alonsete99/Intercomunicador-para-bebes/Placa de interfaz/Esquemáticos/Esquemáticos placa de interfaz.docx

L

A

GND e J_

+5V - - - onn x 2_Fe ,le

U1 u

### + .3V P32-D[VK T -32D

+3.3 INMP 141

3 3 GND GN t G D

ND

2 ve

[N 1 23 - - 3- SD

SE SOP_VP I022 _!j

- - - sw

L/P

S- NSOR_VN T/DO

IQ3L ,XDO

7

]

ser

LED3 1035 ID 1

1032 GND GND B

1033 IQ_9

1 25 I018

D26 105

°' ..... Q_ ..... 1027 I017 U3

1

10_4 D1 LM3 6

t

1 12 104 GN T-

GND1 IDD 1 -

e, w e, ' D1 02 IN-

5D2 IQ_5 ce

1

-º•

º?

SD D1

MD DD

GND GND GND Ex-_sv Lr

o

C1

T+ - - 33 ,F Speare1

o

LS_

h e- :

## File : PI ca de i n -az sel

Title· Placa de interfaz

Size: A4 ele: 2022-01-11 Re : Alonso

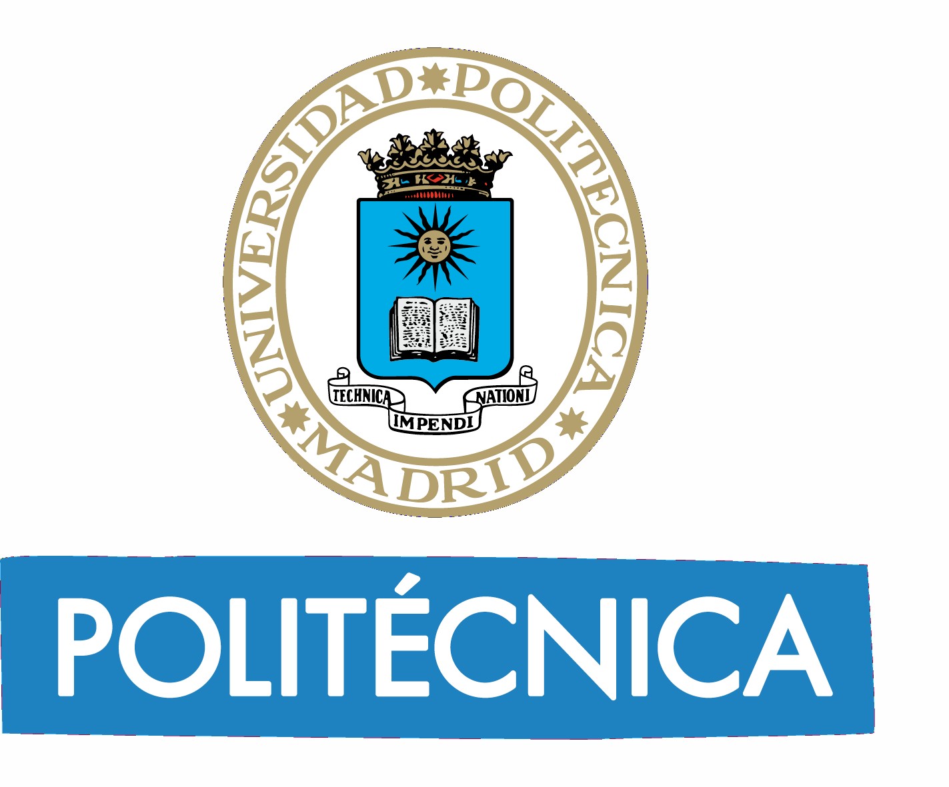
[picture p3: figure]
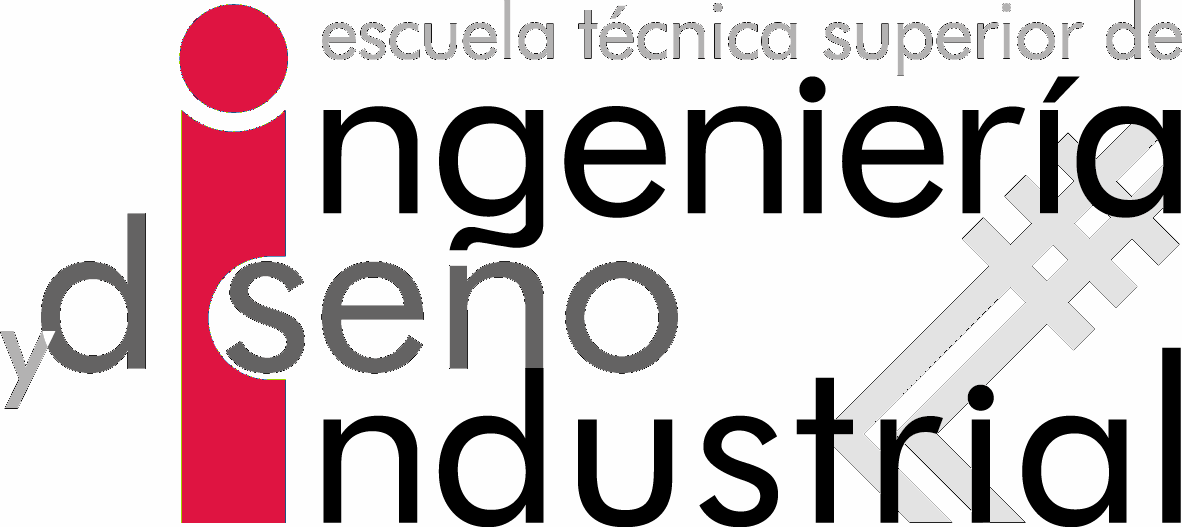
[picture p4: figure]

## KiCad E. O. A.

4

1 icad (5 .1. _0 )- 1

1

# I d : 1/1
