alonsete99/Intercomunicador-para-bebes/TFG_ALONSO_ALAMEDA_MORA.pdf

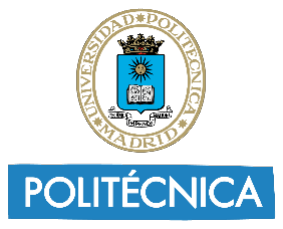
[picture p5: figure]

# UNIVERSIDAD POLITÉCNICA DE MADRID

### ESCUELA TÉCNICA SUPERIOR DE INGENIERÍA Y DISEÑO INDUSTRIAL

## Grado en Ingeniería Electrónica Industrial y Automática

# TRABAJO FIN DE GRADO

## Diseño y construcción de un intercomunicador para bebés

## Autor: Alonso Alameda Mora

Madrid, febrero, 2022

## Tutor: Raquel Cedazo León Departamento de ingeniería

eléctrica, electrónica,
automática y física aplicada.

ii

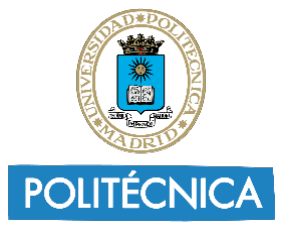
[picture p6: figure]

# UNIVERSIDAD POLITÉCNICA DE MADRID

### ESCUELA TÉCNICA SUPERIOR DE INGENIERÍA Y DISEÑO INDUSTRIAL

## Grado en Ingeniería Electrónica Industrial y Automática

# TRABAJO FIN DE GRADO

## Diseño y construcción de un intercomunicador para bebés

## Autor: Alonso Alameda Mora

Madrid, febrero, 2022

## Tutor: Raquel Cedazo León Departamento de ingeniería

eléctrica, electrónica,
automática y física aplicada.

Título del trabajo:

Autor:

Tutor:

Co-tutor:

### EL TRIBUNAL

### Presidente:

### Vocal:

### Secretario:

Realizado el acto de defensa y lectura del Trabajo Fin de Grado el día ..... de
| de | en | , en la Escuela Técnica Superior de Ingeniería y
Diseño Industrial de la Universidad Politécnica de Madrid, acuerda otorgarle la CALIFICACIÓN de:

VOCAL

SECRETARIO
PRESIDENTE

# AGRADECIMIENTOS

De bien nacido es ser agradecido

# ÍNDICE

AGRADECIMIENTOS | I
ÍNDICE | I
RESUMEN | III
ABSTRACT | IV
GLOSARIO | V
LISTA DE ABREVIATURAS | V
LISTA DE SÍMBOLOS | VI

ii

iii

# RESUMEN

iv

# ABSTRACT

Abstract

v

# GLOSARIO

## LISTA DE ABREVIATURAS

TFG | Trabajo Fin de Grado
ETSIDI | Escuela Técnica Superior de Ingeniería y Diseño Industrial
PCB | Printed Circuit Board (Placa de circuito impreso)
UDP | User Datagram Protocol
IDE | Entorno de Desarrollo Integrado

vi

## LISTA DE SÍMBOLOS

Ω | Ohmio
W | Watio
V | Voltios
Hz | Hercios
dB | Decibelios
mA | Miliamperios

## INDICE DE FIGURAS

FIGURA 6: GRÁFICA POTENCIA A LA SALIDA VS DISIPACIÓN DEL COMPONENTE .... 19

FIGURA 9: DIODO LED ROJO | ¡ (https://upm365-my.sharepoint.com/personal/alonso_alameda_mora_alumnos_upm_es/Documents/TFG_ALONSO_ALAMEDA_MORA.docx)ERROR! MARCADOR NO DEFINIDO. (https://upm365-my.sharepoint.com/personal/alonso_alameda_mora_alumnos_upm_es/Documents/TFG_ALONSO_ALAMEDA_MORA.docx)

# Capítulo 1.INTRODUCCIÓN

### 1.1. INTRODUCCIÓN AL TEMA DEL TFG

### 1.2. MOTIVACIONES

Introducción

### 1.3. OBJETIVOS

El objetivo de este trabajo es diseñar y construir un intercomunicador especializado para bebes. Como objetivos específicos tenemos:

- Diseño y construcción del hardware del intercomunicador.
- Desarrollo del software que controla todos los componentes del intercomunicador
- Desarrollo de una aplicación móvil que se comunique con el intercomunicador y envía sonido en ambos sentidos
- Realizar pruebas de funcionamiento del intercomunicador.

### 1.4. ESTRUCTURA DEL DOCUMENTO

# Capítulo 2.ESTADO DEL ARTE

## 2.1. ORIGEN

La tecnología de comunicación entre oficinas es anterior a los walkie-talkies por décadas. Después de que Kellogg patentara el primer sistema de intercomunicación telefónica en 1894, la capacidad de comunicarse con los empleados o transmitir informes oficiales a todo el edificio dio un gran paso adelante. Como sugiere el nombre, los primeros walkie-talkies dependían de la tecnología de telefonía, pero los fabricantes continuaron mejorando el sistema mediante la adopción de nuevas tecnologías.

Tubos de lengua

Las empresas del siglo XIX desarrollaron métodos de comunicación entre varias oficinas de patentes antes de Kellogg. A principios de la década de 1800, los ingenieros construyeron tuberías para transmitir sonido entre dos altavoces en el mismo edificio. Algunos sistemas funcionan a distancias de cientos de metros. La tubería se convirtió en una tecnología comercial común en la segunda mitad del siglo. En la década de 1880, el sistema era lo suficientemente sofisticado como para que los parlantes pudieran conectarse a cualquiera de las 25 oficinas diferentes. Algunos ejecutivos prefieren una alternativa, un sistema de timbre de habitación en habitación para llamar a sus empleados.

Intercomunicadores basados en teléfonos

Este tipo de intercomunicadores se desarrollaron en la década de 1890. Estos sistemas conectaban dos teléfonos de dos oficinas distintas, pero pronto se empezaron a desarrollar conexiones más complejas. Se diseño el primer sistema radial, el cual los usuarios tenían que llamar a una estación central donde se le redirigía a la oficina la cual se querían poner en contacto.

Intercomunicadores durante el siglo XX

Durante el año 1912, los usuarios ya tenían la opción de elegir entre un teléfono o un altavoz el cual les permitía trabajar con las manos desocupadas. En esta década la mayoría de los intercomunicadores todavía se parecía a lo que convencionalmente llamamos como teléfono. A partir de la década de 1950, los intercomunicadores empezaron a ser utilizados como porteros electrónicos para realizar la comunicación y apertura de los edificios. El gran cambio en los intercomunicadores llegó a raíz de la invención del transistor en el año 1951 por William Shockley[1].

A partir de la invención del transistor se inició la etapa de la digitalización. A partir del 1982, los fabricantes de intercomunicadores empezaron a vender dispositivo que además de audio incorporaban video.

Esta información se ha obtenido de la siguiente referencia [2]

# Capítulo 3.FUNDAMENTOS

# TEÓRICOS

### 3.1. ¿QUÉ ES UN INTERCOMUNICADOR?

Un intercomunicador es un dispositivo electrónico de comunicación bidireccional¹ que permite la comunicación entre dos interlocutores a través de una conexión establecida entre ambos.

1 Bidireccional: Comunicación que se realiza en dos sentidos, desde el emisor al receptor y viceversa.

### 3.2. EL SONIDO

## 3.3. WIFI

3.4. I2S

I2S o también conocido como Inter-IC Sound, es un estándar de bus serie que se utiliza para conectar diferentes dispositivos de audio de manera digital. Este estándar tiene la particularidad de poder habilitar el acceso directo a memoria o más comúnmente llamado DMA.

## 3.5. USER DATAGRAM PROTOCOL (UDP)

# Capítulo 4.DISEÑO HARDWARE

### 4.1. DESCRIPCIÓN DE LOS COMPONENTES UTILIZADOS

En este apartado se va a explicar con profundidad las diferentes alternativas que hay en el mercado para cada parte fundamental del proyecto. En primer lugar, para este proyecto se planteó la idea de diseñar dos dispositivos que se comunicaran entre ellos. Esta idea encarecía bastante el sistema y no habría ningún tipo de mejora con respecto a un intercomunicador para bebes convencional. Por tanto, se decidió diseñar solo un dispositivo que se comunicara con la aplicación móvil.

Las partes fundamentales del dispositivo son las siguientes:

- Microcontrolador
- Micrófono
- Altavoz
- Etapa preamplificadora de señal
- Diodos Led
- Fuente de alimentación

4.1.1. MICROCONTROLADOR

Como elección de microcontrolador se ha elegido el ESP-WROOM-32, se trata de un módulo que dispone de WIFI y Bluetooth, el cuál es ideal para el proyecto ya que toda la comunicación entre la aplicación móvil y el microcontrolador va a ser inalámbrica. Además, este módulo tiene un consumo energético cuando se encuentra en reposo muy bajo (5 μA aproximadamente). Este módulo está fabricado por la empresa Espressif, la cual tiene una amplia guía de programación, en la cual se detallan cómo programar integrar las diferentes funciones y librerías que tiene el módulo disponible.

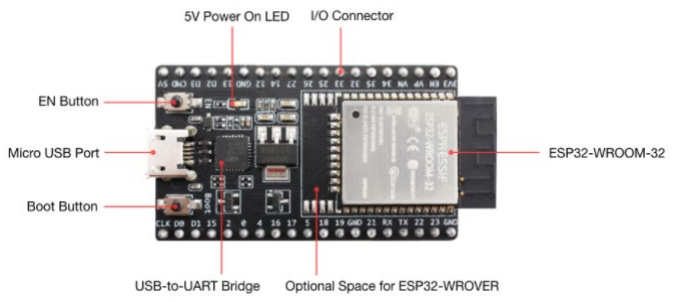
[picture p7: figure]

Figura 1: ESP32-DevKitC V4.

Otro valor diferencial en cuanto a otras placas del mercado es su tamaño reducido ya que mide 56x28mm. Esto hace que uno de los requisitos de este proyecto se pueda cumplir ya que es primordial que el intercomunicador tenga un tamaño reducido para que sea lo más portable posible.

Por último, esta placa dispone del estándar I2S, como se explica con más detalle en el apartado 3.4, se va a utilizar para digitalizar la señal de audio recibida del micrófono. Una vez que la señal analógica se encuentre digitalizada se realizará un paquete de formato UDP y se enviará a la aplicación móvil.

EXTENDERSE UN POCO MÁS EN LAS CARACTERISTICAS DE LA PLACA FLASH RAM,ETC

4.1.2. MICRÓFONO

Como micrófono se ha elegido el INMP441. Se trata de un micrófono omnidireccional² basado en el protocolo I2S, con una precisión de muestras de hasta 24 bits. Tiene una respuesta en frecuencia desde 60Hz hasta 15kHz, lo que hace que se más que suficiente para integrarlo en el intercomunicador. Además, este micrófono se alimenta a una tensión de 3.3V, que se pueden obtener del regulador DC/DC de 5V a 3.3V que tiene integrado el módulo de ESP32.

Este micrófono viene integrado sobre una placa de interfaz la cual es fácil de poder soldarse posteriormente sobre una PCB.

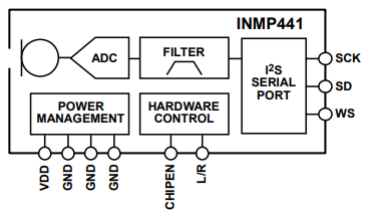
[picture p8: figure]
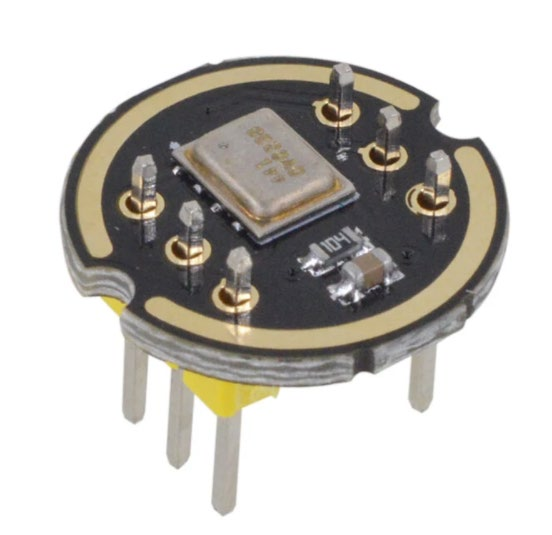
[picture p9: figure]

2 Micrófonos omnidireccionales: son aquellos los cuales tienen una sensibilidad constante, esto significa que capta los sonidos en todas las direcciones. Fuente: Wikipedia.org

Figura 2: Diagrama de bloques INMP441 Figura 3: Placa de interfaz INMP441

### 4.1.3. ALTAVOZ

El altavoz es el encargado de transformar la señal eléctrica que transmite la placa ESP32 en sonido. Para ello se ha elegido un altavoz de 8 Ω, el cual tiene unas dimensiones de 28 mm de diámetro y tiene una potencia nominal de 0.25W. Además, como se puede observar en la Figura 5, la respuesta del altavoz se va a encontrar entre 80-90dB ya que la canción que se va a reproducir no tiene un espectro con altas frecuencias, lo que hace que el altavoz no llegue a saturarse y por tanto reproduzca un sonido con mala calidad.

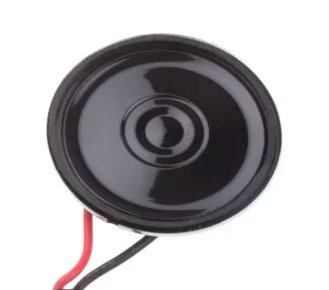
[picture p10: figure]
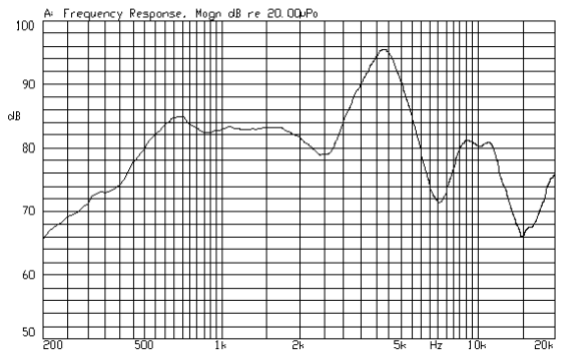
[picture p11: figure]

4.1.4.ETAPA AMPLIFICADORA DE SEÑAL

Esta etapa es necesaria de añadir entre el altavoz y el módulo ESP32 ya que este módulo es capaz de suministrar una señal de salida de 15 mA, lo cual es insuficiente para que en el altavoz se escuche el sonido con claridad. Si se conecta directamente el altavoz al módulo consumiría una potencia máxima que se muestra en la siguiente ecuación:

# PPmmmmmm = VV ∗ IImmmmmm = 3.3VV ∗ 15mmmm = 49.5mmmm

Esto hace que la potencia máxima consumida sea del 19.8% del valor total del altavoz. Por tanto, hay que añadirle la etapa amplificadora de señal para que ese porcentaje se aproxime al 100% del valor de potencia.

Figura 4: Altavoz 8 Ω | Figura 5: Respuesta en frecuencia del Altavoz

Como amplificador se ha elegido el LM386, el cual es un amplificador operacional diseñado explícitamente para trabajar en labores de sonido. Este amplificador tiene las siguientes características:

Tabla 1: Características

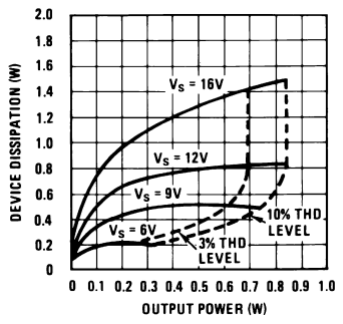
[picture p12: figure]
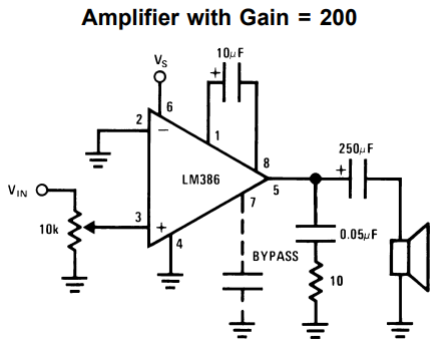
[picture p13: figure]

Como se muestra en la Figura 6, la curva inferior va a ser la que represente la potencia en la salida del amplificador, ya que el sistema se va a encontrar alimentado por 6V. Con esto se observa que la potencia máxima a la salida va a ser de 0.3W lo cual es aproximadamente la misma potencia que soporta el altavoz. Además, si no se superan los 0.3W el THD es del 0.2%, lo cual hace que la señal no se distorsione al aumentar la tensión a la salida del módulo.

Parámetro | Valor
Tensión de alimentación | 4-12V
Ganancia en la tensión de salida | 26-46dB
Ancho de banda | 300kHz
Distorsión armónica total | 0.2%

Figura 6: Gráfica potencia a la salida vs disipación del componente

Figura 7: Circuito amplificador con ganancia 200

Para hacer el diseño lo más simplificado posible, se ha decidido comprar este amplificador operacional pero ya montado y soldado sobre un módulo. Además, ya vienen incluido todos los componentes que aparecen en la Figura 7. Este diseño dispone de un amplificador LM386 con una etapa de filtrado a la salida compuesta por un condensador y una resistencia. También dispone de un potenciómetro a la entrada del amplificador para regular la ganancia total del circuito y diferentes conectores para poder incluirlo dentro del prototipo.

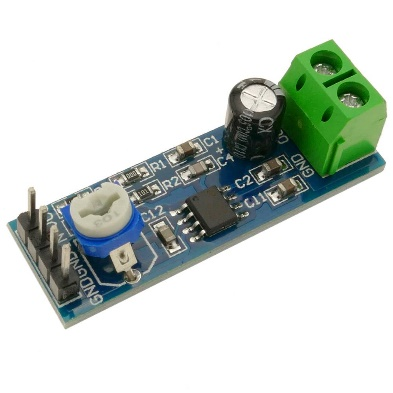
[picture p14: figure]

4.1.5.FUENTE DE ALIMENTACIÓN

Para alimentar todo el prototipo se ha decidido utilizar un conjunto de pilas de 1.5V. Este conjunto está formado por 4 pilas de tipo AAA, las cuales en su conjunto son capaces de suministrar al dispositivo 6V ya que todas se encuentran conectadas en serie entre sí. Se ha decidió elegir el conjunto de pilas ya que la mayoría de las baterías del mercado de dimensiones pequeñas suministraban a la salida una tensión de 3.3V, la cual no era suficiente ya que el módulo amplificador trabaja a una tensión mínima de 6V. Teniendo en cuenta que el conjunto de 4 pilas tiene una capacidad total de 1200 mAh. Se realiza un cálculo para conocer cada cuanto tiempo será necesario cambiar las pilas.

# TTTTTT TTTT = EEEE EEEEíaa ssss ssss ss

# PP PP (MMó dd EEEE 32 + MM ) = 6VV ∗ 1200mmmmℎ 80mmmm ∗ 3.3VV + 1.4mmmm ∗ 3.3VV = 26.86 ℎ

Por tanto, se concluye que la duración media del conjunto de pilas va a ser de 27 horas aproximadamente. Este cálculo se ha realizado teniendo como consumo principal el del

Figura 8: Módulo amplificador de potencia módulo ESP32 y el micrófono ya que van a ser los dispositivos que se van a encontrar la mayoría del tiempo funcionando cuando el dispositivo se encuentre encendido.

4.1.6. DIODOS LEDS

Los diodos leds son los encargados de notificar al usuario ante diferentes funciones que está desempeñando la placa. Para ello, se ha decidido utilizar diodos de color rojo, los cuales tienen una buena intensidad lumínica y buena durabilidad. Para el diseño inicial se han incluido 3 Leds los cuales tienen las siguientes funcionalidades:

- LED 1: Este led es el encargado de notificar al usuario de que se ha conectado correctamente a la red Wifi creada por el intercomunicador. Además, si por cualquier motivo el cliente se desconecta de la red se apaga para que el usuario no tenga dudas si la conexión es correcta.
- LED 2: Este es el diodo que se encuentra en la parte central de la hilera de leds. En este caso, notifica al usuario de que se ha iniciado el modo de escucha y por tanto todo lo que escuche el micrófono se va a enviar a la aplicación móvil, donde se reproducirá el sonido ininterrumpidamente.
- LED 3: En este caso, notifica al usuario que se ha iniciado el modo de reproducción de sonido por el altavoz. Una vez que se inicialice este modo aparecerá por el micrófono una canción que recibe el módulo ESP32 de la aplicación móvil.

Por último, todos los leds tienen conectados en serie una resistencia fija de valor 1kΩ, la cuales son las encargadas de limitar la corriente que circula a través de los diodos. El conjunto de diodo y resistencia se encuentran conectados a la placa como se muestra en la Figura 10, la cual es capaz de suministrar una tensión de 3.3V. Estos diodos tienen una caída de tensión entre sus bornas de 1.9V y una tensión máxima de operación definida por el fabricante de 30 mA. Como se muestra en la siguiente ecuación, la resistencia en serie del diodo debe tener un valor superior al obtenido ya que con ello se obtendrá una corriente menor a la máxima dada por el fabricante y no habrá riesgo de que se fundan.

RR ≥

# TTTT TTó aa aa ó − CC ó

# CC aa aa = 3.3VV − 1.9VV

30 ∗ 10−3 = 46.6 Ω

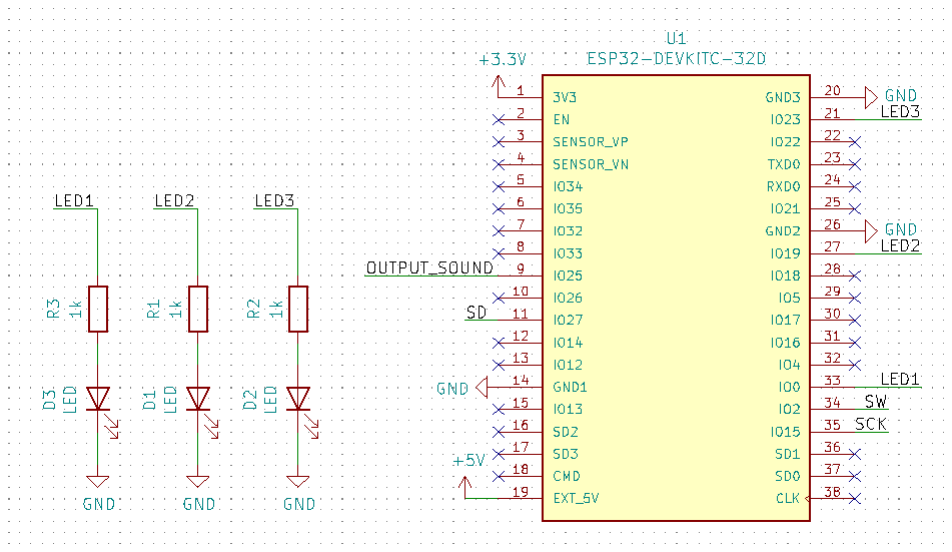
[picture p15: figure]
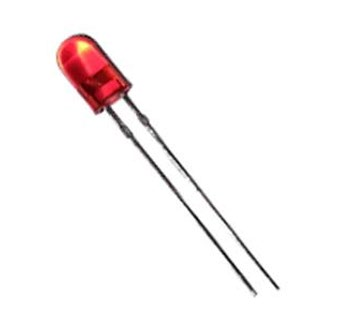
[picture p16: figure]

Figura 9: Diodo LED rojo | Figura 10: Conexión LEDs con ESP32

# Capítulo 5.DISEÑO SOFTWARE

5.1.1.INTRODUCCIÓN

En el siguiente capitulo se va a explicar con detalle todo el proceso que se ha seguido hasta conseguir que el dispositivo funcione correctamente. En primer lugar, se expone el programa realizado para el módulo ESP32. Este software está basado en el lenguaje de programación C++, el cual se ha estudiado con bastante detalle a lo largo de los estudios de grado.

En segundo lugar, se explicará el funcionamiento y programación de la aplicación móvil diseñada expresamente para este desempeño. Este programa a diferencia del anterior se encuentra desarrollado en Java, el cual me ha costado más ya que no lo había estudiado con anterioridad.

Por último, se va a exponer un programa que se ha realizado para ir comprobando que el sonido se estaba transmitiendo correctamente en ambos sentidos. Este programa se encuentra desarrollado en Python ya que este lenguaje de programación dispone de una librería la cual hacía muy sencillo poder reproducir sonido a través de un socket UDP.

5.1.2. CONEXIÓN INALÁMBRICA

Como se ha explicado con anterioridad, se va a realizar una conexión inalámbrica entre el módulo ESP32 y el dispositivo móvil. Para ello, el ESP32 se va a programar de manera que se comporte como Punto de acceso Wifi. Una vez que la red local se haya creado correctamente, el dispositivo móvil se deberá conectar a ella y entra a la aplicación móvil.

Desde la aplicación móvil se podrá elegir entre los dos modos de comunicación implementados. En el primer modo, el dispositivo móvil abrirá el archivo de la canción que se desea enviar para relajar al bebe, guardado dentro de la aplicación. Estos datos posteriormente se irán enviando por orden para que una vez que el ESP32 reciba dicha información la reproduzca por el altavoz del intercomunicador.

El segundo modo, el ESP32 obtendrá el sonido ambiente desde el micrófono que se encuentra integrado en el intercomunicador, realizará una amplificación de señal digitalmente para que se escuche con un volumen más alto y nítido y se enviará al dispositivo móvil donde se reproducirá por el altavoz del dispositivo. El objetivo es que esta comunicación se realice con el menor retardo posible y con la mejor calidad de sonido.

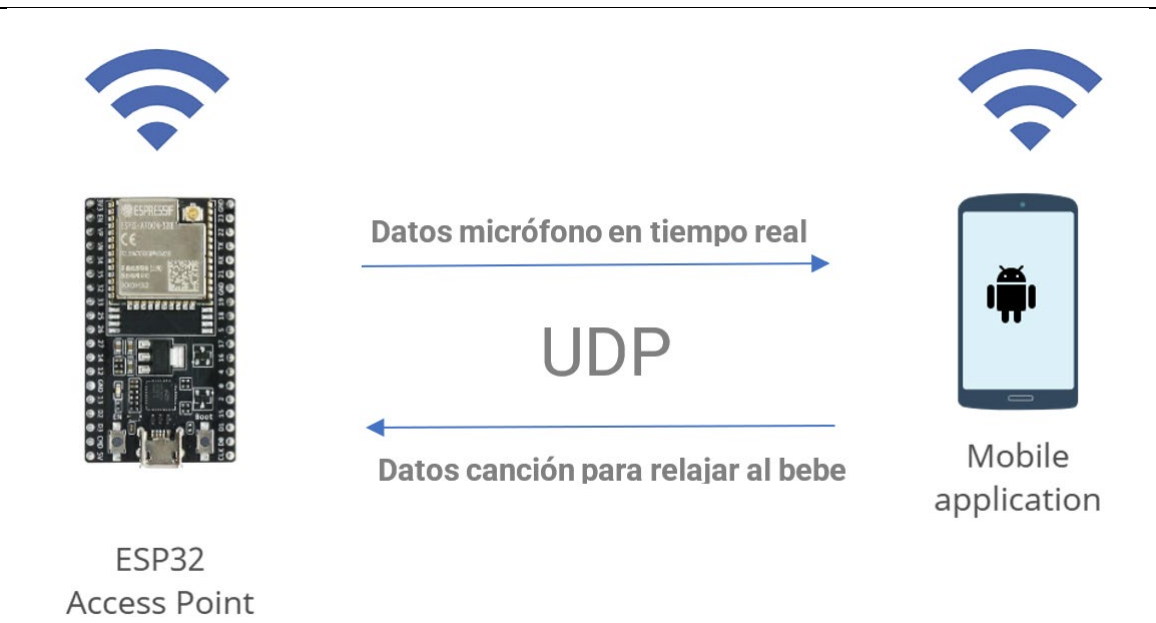
[picture p17: figure]

Figura 11: Diagrama de conexión inalámbrica

### 5.1.3. SOFTWARE PLACA ESP32

Este módulo se ha decidido programarse con el IDE de Arduino ya que tiene ya integradas muchas librerías especializadas para poder desempeñar las tareas que deseo. Además, Arduino tiene una comunidad muy activa en sus foros y si se tiene algún problema con alguna parte del código suele haber alguna solución ya planteada para dicho programa. Otra alternativa para programar el módulo era utilizar Visual Studio Code con la extensión de PlataformIO instalada. El problema con esta extensión era que en muchas ocasiones me aparecían fallos al programar código que hacía que el módulo estuviera constantemente reiniciándose. Este fallo creo que era porque al añadir varias clases al proyecto global hacía que superara la memoria Flash del módulo, haciendo que me imprimiera un fallo del Kernel de la placa y reiniciara constantemente el módulo.

Para realizar el programa completo del módulo se ha utilizado la guía de programación que tiene la empresa Espressif. Se trata de una guía muy completa donde se explican todos los parámetros primordiales para poder programar su módulo. Entre ellos he utilizado con mayor frecuencia el de Bluetooth, Wifi o I2S.

A continuación, se va a explicar con detalle todas las funciones implementadas en el código:

- ReceivingTask(): Esta tarea se encarga en recibir continuamente datos desde la aplicación móvil y reproducirlos por el altavoz del dispositivo. Para ello se crea un buffer de 1024 bytes, el cual va a ser el encargado en almacenar la información. Se utiliza el comando “read” de la librería UDP.h. Este comando espera hasta que llegue un dato de 1024 bytes y lo almacena en el buffer llamado “buff_reciv”. Una vez que se ha detectado que ha llegado un dato, se realiza un bucle en el cual se escribe en el conversor digital analógico que tiene dicha placa. Para ello, se utiliza el comando “dacWrite”, el cual hay que especificarle el pin de la placa por donde quieres que salga la información (Pin 25) y la muestra que quieres hacer la conversión (“buff_reciv[i]”). Por último, se realiza una espera por cada muestra de 56 µs. Este valor se obtiene porque la canción enviada tiene una frecuencia de muestras de 16kHz. Por tanto, aplicando la siguiente formula se obtiene el valor de retardo:

TT = 1

ff = 1

# 16000 = 62.5µss

A este retardo obtenido hay que restarle 7µs aproximadamente que es lo que tarda la placa en realizar la conversión del dato digital en analógico, con lo que finalmente se obtiene el valor de 56 µs de retardo entre cada muestra.

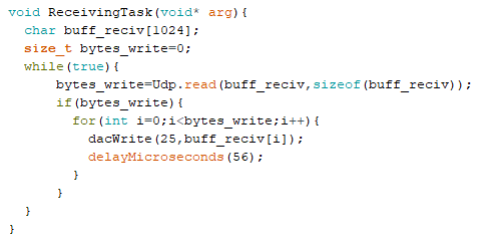
[picture p18: figure]

- SendingTask(): Esta tarea es la encargada de enviar los datos obtenidos del micrófono a la aplicación móvil a través de un socket UDP.

Figura 12: Función ReceivingTask()

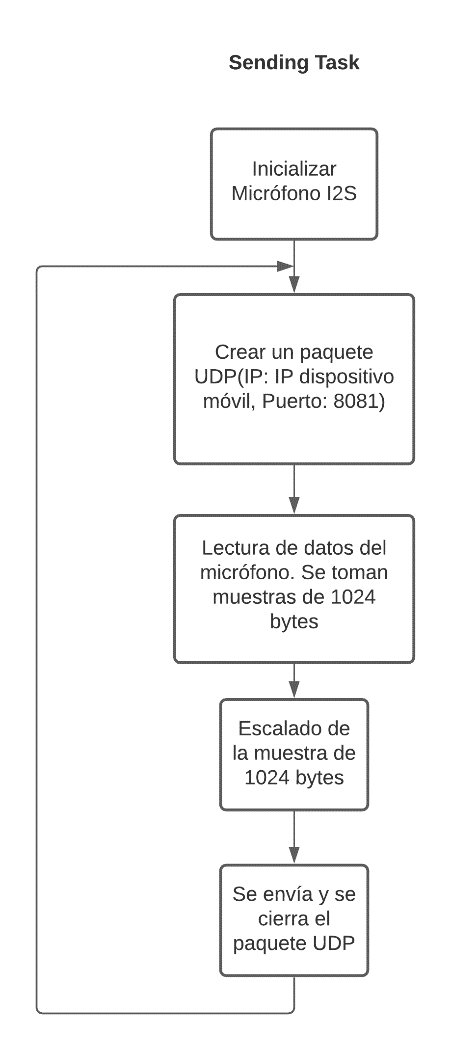
[picture p19: figure]

Figura 13: Diagrama de flujo función SendingTask()

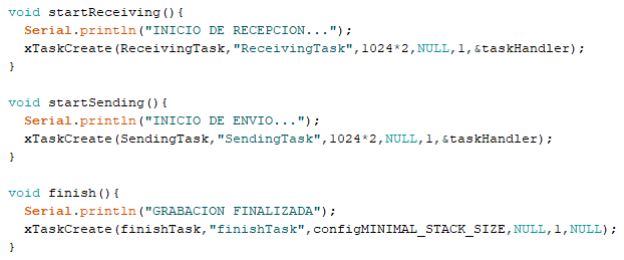
[picture p20: figure]

Figura 14: Funciones que crean las tareas

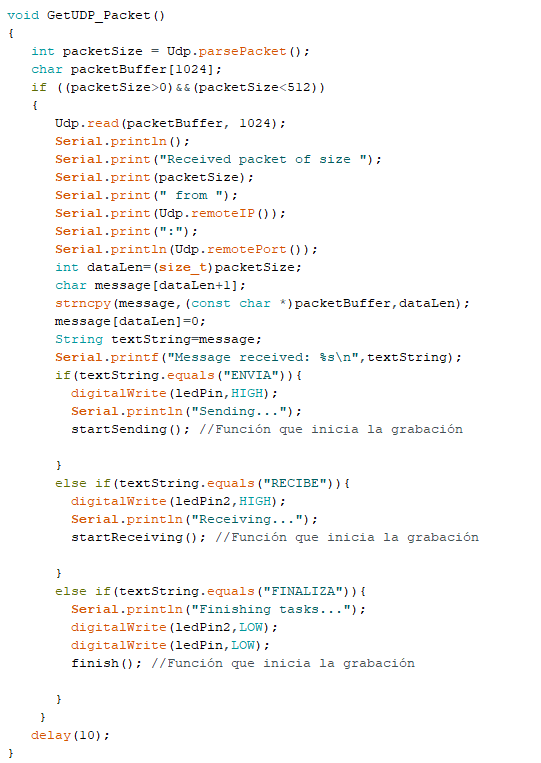
[picture p21: figure]

Figura 15: Función GetUDP_Packet()

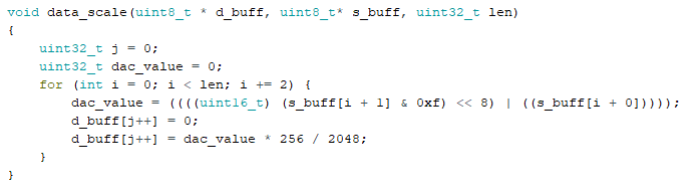
[picture p22: figure]
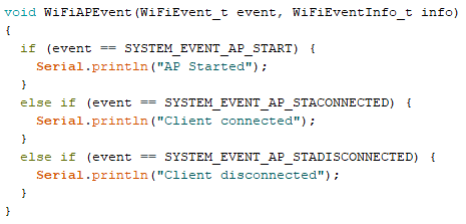
[picture p23: figure]

Figura 17:Función WiFiAPEvent()

Figura 16: Función data_scale()

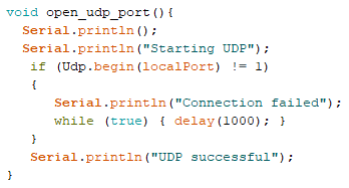
[picture p24: figure]

Figura 18: Función open_udp_port()

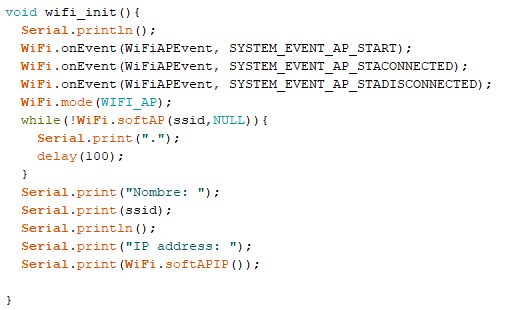
[picture p25: figure]

Figura 19: Función wifi_init()

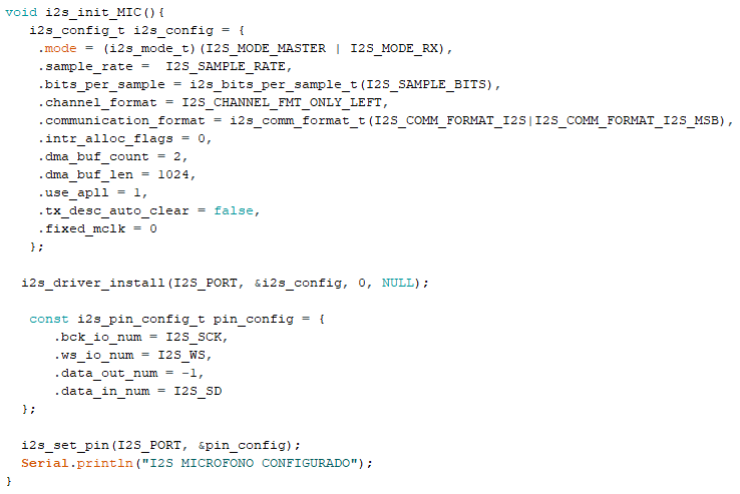
[picture p26: figure]

Figura 20: i2s_init_MIC()

5.1.4. SOFTWARE APLICACIÓN MÓVIL

En este caso se ha utilizado Android Studio para implementar la aplicación desde cero. Se trata de un entorno de programación muy cómodo ya que tienen implementadas muchas librerías de java las cuales son fáciles de importar e implementar en el código.

# Capítulo 6.RESULTADOS

### 6.1. RESULTADOS

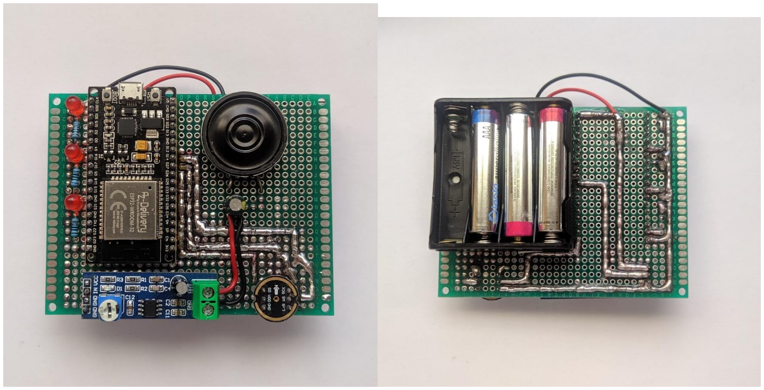
[picture p27: figure]

### 6.2. DISCUSIÓN

# Capítulo 7.CONCLUSIONES Y FUTUROS TRABAJOS

### 7.1. CONCLUSIONES

## 7.2. FUTUROS TRABAJOS

# BIBLIOGRAFÍA

[1] | “Historia | del | transistor | - | Wikipedia, | la | enciclopedia | libre.”
https://es.wikipedia.org/wiki/Historia_del_transistor (accessed Jan. 19, 2022).
[2] | “Historia | de | los | sistemas | de | intercomunicación | / | Pretexsa.com.”
http://www.pretexsa.com/eM9A20DM.html (accessed Jan. 19, 2022).

# ANEXO A. ANEXO DE EJEMPLO

### A.1. SECCIÓN 1 DEL ANEXO
