alonsete99/Intercomunicador-para-bebes/Placa de interfaz/Imagenes modelo 3D/Vista inferior.png

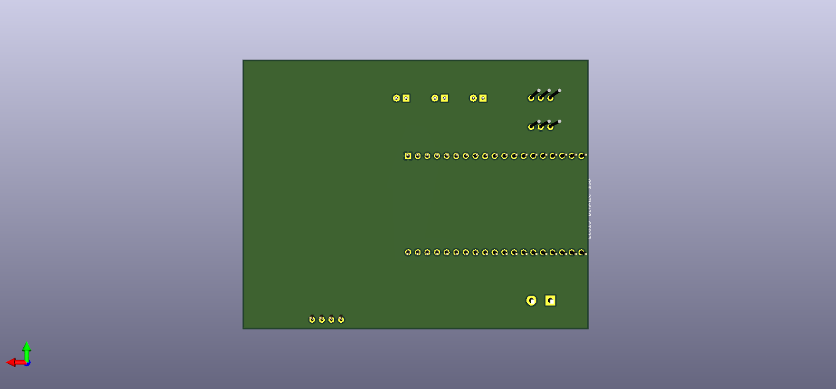
Placa de interfaz/Imagenes modelo 3D/Vista inferior.png
