alonsete99/Intercomunicador-para-bebes/Bill of material TFG.xlsx

Producto | Descripcion | Precio | Enlace
Placa ESP32 | Tiene bluetooth y hace todo el procesado de la señal | 9.79 € | https://www.amazon.es/gp/product/B071P98VTG/ref=ox_sc_act_title_2?smid=A1X7QLRQH87QA3&th=1
Microfono I2S | Digitaliza la señal analógica para que la placa la interprete | 9.81 € | https://www.amazon.es/gp/product/B07RHMLYKD/ref=ox_sc_act_title_1?smid=A13P6277X44WWB&psc=1
Altavoz | Tengo uno de proyectos anteriores que he hecho | 3.30 € | https://es.rs-online.com/web/p/altavoces-en-miniatura/7716991
Bateria o módulo de pilas | Comprar mas tarde si vemos que es necesario | 0.59 € | https://cablematic.com/es/productos/portapilas-plano-para-4-pilas-aaa-lr03-de-15v-ET013/
Carcasa 3D | Según el diseño final de la carcasa | - | -
Circuito preamplificador de la señal | Por ahora no es necesario comprarlo | 2.36 € | https://cablematic.com/es/productos/circuito-integrado-de-amplificador-de-audio-lm386-modelo-dw-0860-AJ091/
PCB |  | 1.69 € | https://cablematic.com/es/productos/placa-pcb-de-prototipo-de-circuito-impreso-de-soldadura-de-doble-cara-7x9cm-CT097/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
 | TOTAL | 27.54 €
