alonsete99/Intercomunicador-para-bebes/Placa de interfaz/Huellas y 3Ds/INMP441_module v4.step

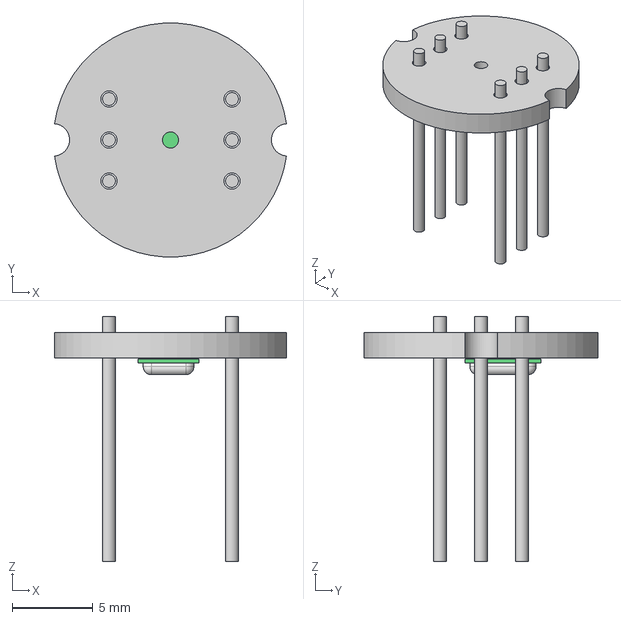
[picture p29: CAD file, 2022-02-01]
Placa de interfaz/Huellas y 3Ds/INMP441_module v4.step
14.4 x 14.5 x 15.2 mm
Product
pins
