alonsete99/Intercomunicador-para-bebes/Placa de interfaz/Huellas y 3Ds/Speaker.STEP

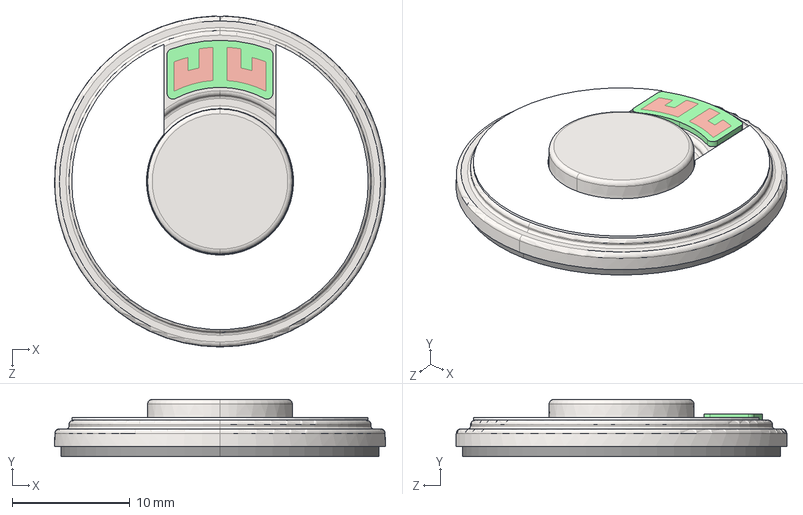
[picture p30: CAD file, 2022-02-01]
Placa de interfaz/Huellas y 3Ds/Speaker.STEP
28.1 x 4.85 x 28.1 mm
