alonsete99/Intercomunicador-para-bebes/Placa de interfaz/Huellas y 3Ds/Amplificador LM386 .step

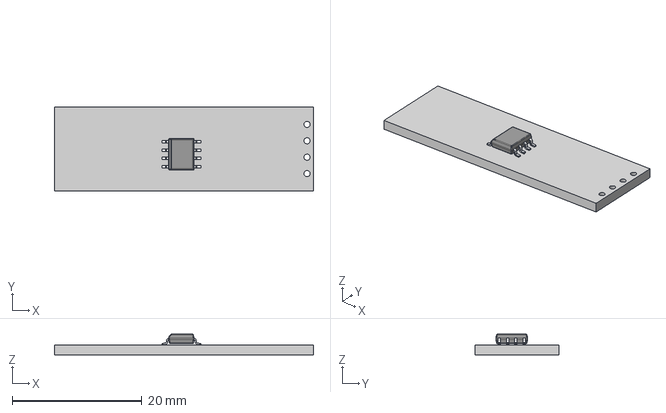
[picture p31: CAD file, 2022-02-01]
Placa de interfaz/Huellas y 3Ds/Amplificador LM386 .step
40.0 x 13.0 x 3.19 mm
BODY-SO
LEAD-D0008A x 8
