alonsete99/Intercomunicador-para-bebes/Placa de interfaz/Esquemáticos/Esquemáticos placa de interfaz.pdf

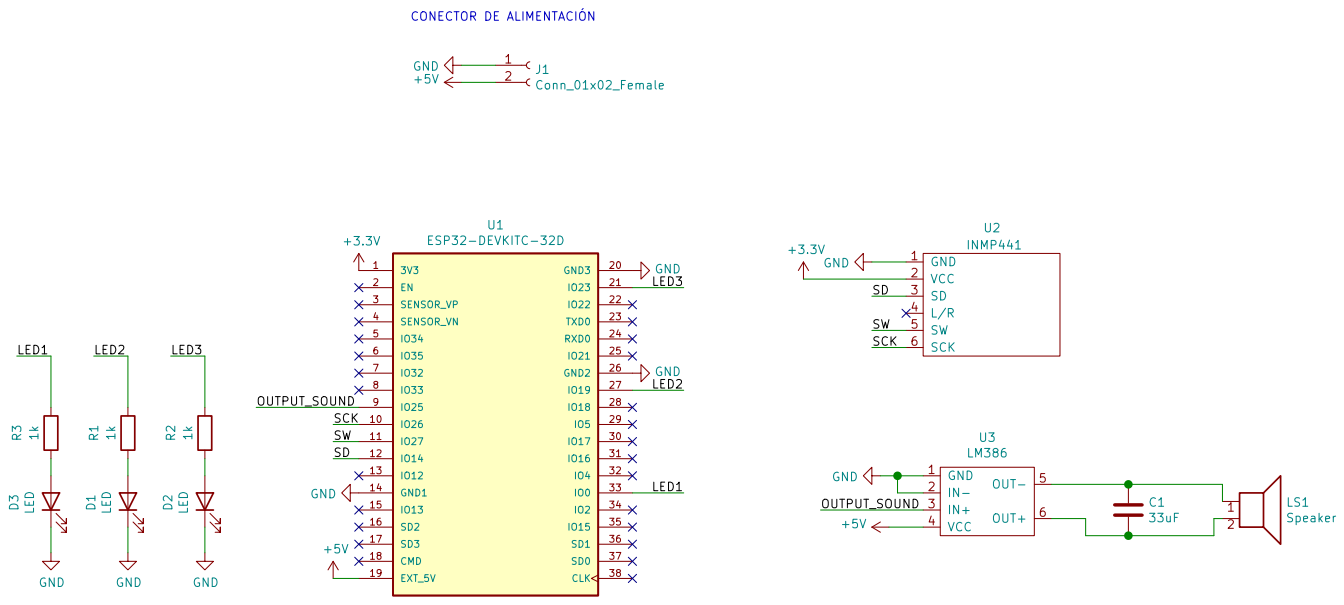
[picture p32: page 1]

File: Placa de interfaz.sch Sheet: /
Id: 1/1 Title: Placa de interfaz
