alonsete99/Intercomunicador-para-bebes/Placa de interfaz/Esquemáticos/Placa de interfaz.pdf

File: Placa de interfaz.sch Sheet: /
Id: 1/1 Title: Placa de interfaz
