alonsete99/Intercomunicador-para-bebes/Placa de interfaz/Placa de interfaz.kicad_pcb

## KiCad design Placa de interfaz/Placa de interfaz.kicad_pcb (2022-02-01)

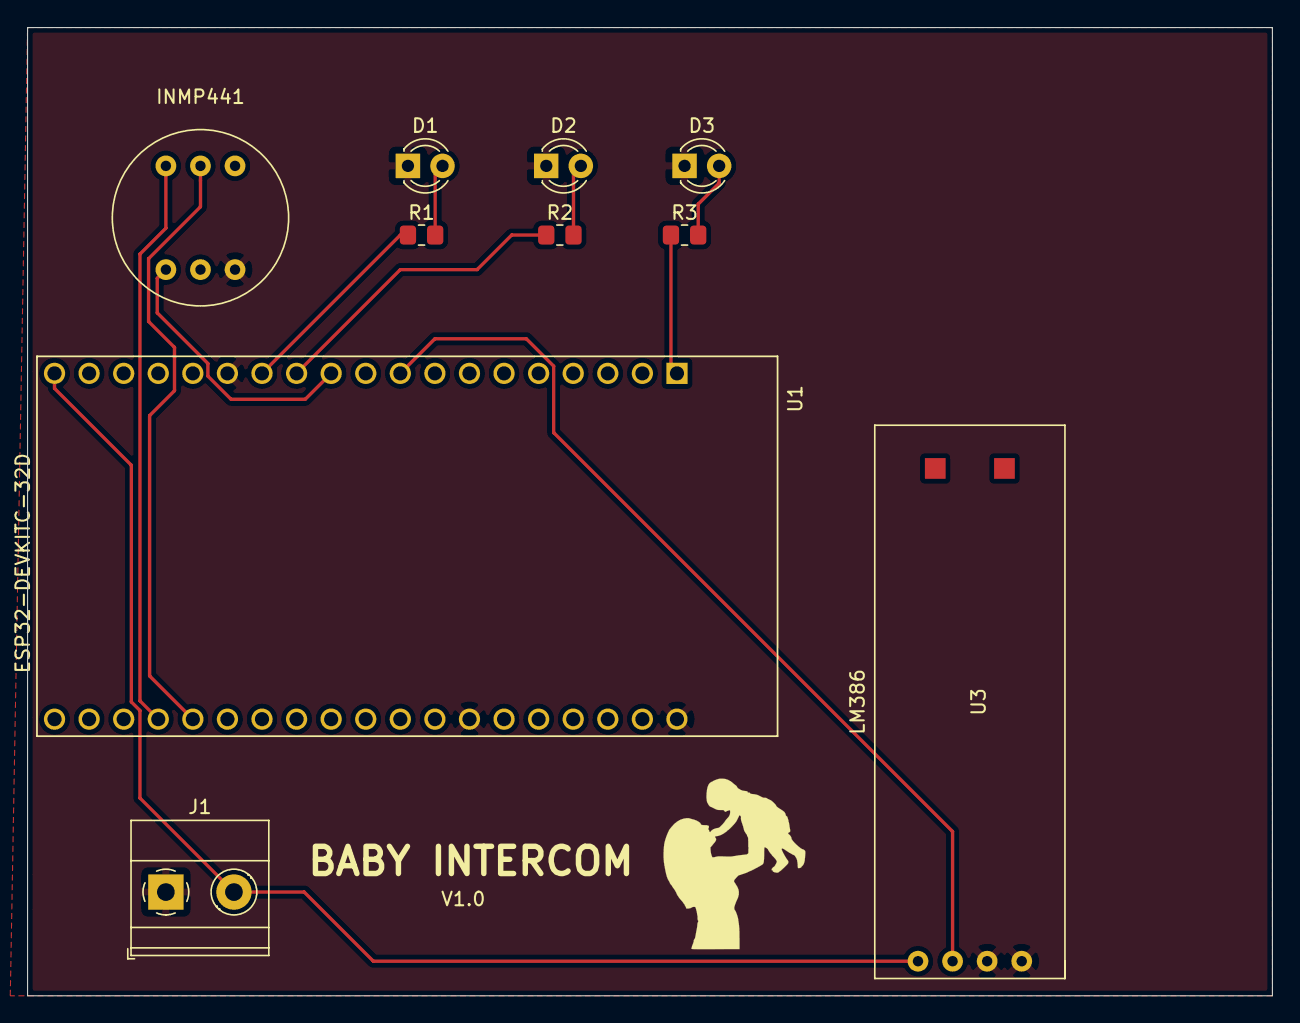
[picture p33: board Placa de interfaz.kicad_pcb from above]

Board: 2 copper layers, 91.4 x 71.1 mm, 10 parts (0 on the bottom side), 12 nets.

Parts:
D1, D2, D3: LED; LED_D3.0mm_IRGrey
J1: Conn_01x02_Female; TerminalBlock_Phoenix_MKDS-1,5-2_1x02_P5.00mm_Horizontal
R1, R2, R3: 1k; R_0805_2012Metric_Pad1.20x1.40mm_HandSolder
U1: ESP32-DEVKITC-32D; MODULE_ESP32-DEVKITC-32D
U2: INMP441
U3: LM386; lm386_amplifier

Connections:
+3V3: R3.1, U1.1, U2.2
+5V: J1.2, U1.19, U3.4
/LED1: R1.1, U1.13
/LED2: R2.1, U1.12
/OUTPUT_SOUND: U1.9, U3.3
/SCK: U1.35, U2.6
/SD: U1.11, U2.3
/SW: U1.34, U2.5
GND: D1.1, D2.1, D3.1, J1.1, U1.14, U1.20, U1.26, U2.1, U3.1, U3.2
unnamed: D1.2, R1.2
unnamed: D2.2, R2.2
unnamed: D3.2, R3.2
